aryanb1032/KASHIF-Autonomous-Mapping-Rover/hardware/README.md

# Mechanical files

Original STL files are in `stl/`, with filenames preserved. All eight meshes pass binary STL length/count checks. Print units, tolerances, assembly fit and the drive layout still require physical verification. These files are not used by the Gazebo model.

`CHASSIS.STL` and `CHASSIS (1).STL` are byte-identical copies retained from the supplied folder.
