aryanb1032/KASHIF-Autonomous-Mapping-Rover/hardware/stl/tpu wheel.stl

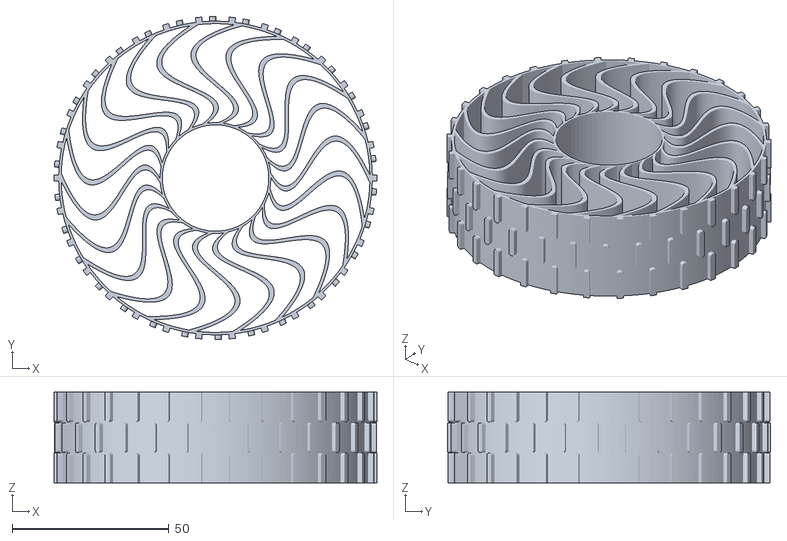
[picture p1: CAD file, 2026-11-10]
hardware/stl/tpu wheel.stl
103.0 x 103.0 x 29.0
