aryanb1032/KASHIF-Autonomous-Mapping-Rover/hardware/stl/rim.STL

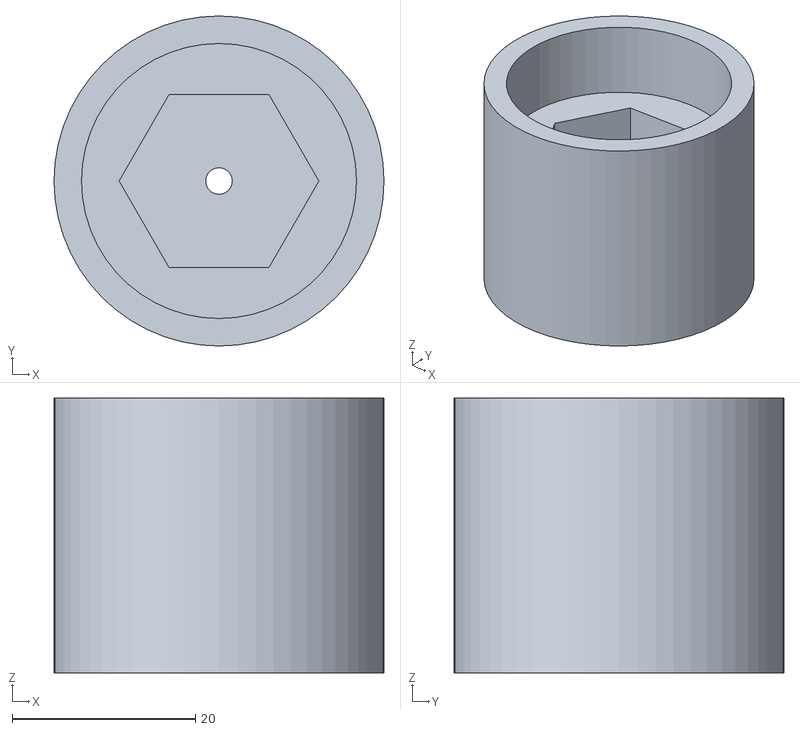
[picture p2: CAD file, 2026-11-10]
hardware/stl/rim.STL
36.0 x 36.0 x 30.0
