aryanb1032/KASHIF-Autonomous-Mapping-Rover/hardware/stl/hex 5.STL

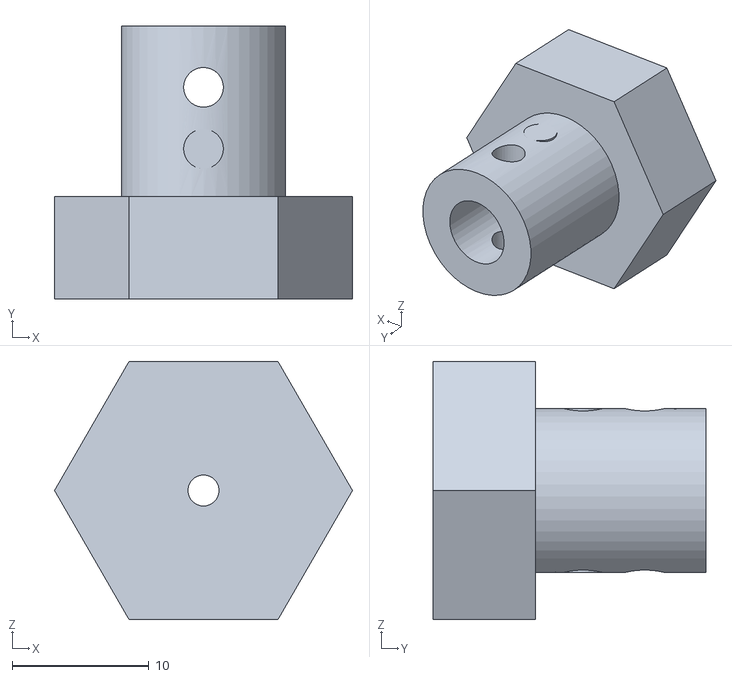
[picture p3: CAD file, 2026-11-10]
hardware/stl/hex 5.STL
21.8 x 20.0 x 18.9
