aryanb1032/KASHIF-Autonomous-Mapping-Rover/hardware/stl/lidar cover.STL

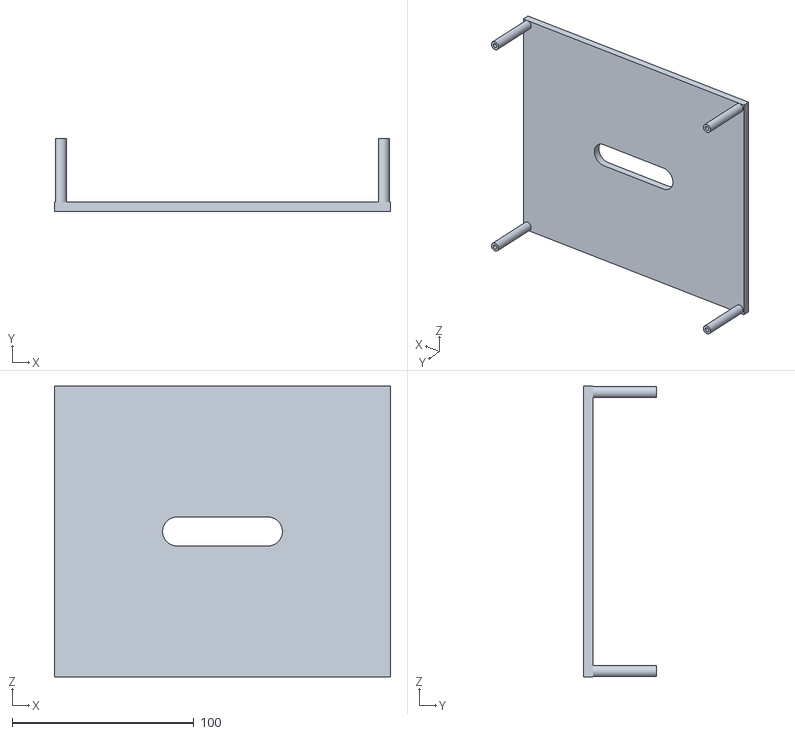
[picture p4: CAD file, 2026-11-10]
hardware/stl/lidar cover.STL
185.0 x 40.0 x 160.0
