aryanb1032/KASHIF-Autonomous-Mapping-Rover/hardware/stl/CHASSIS.STL

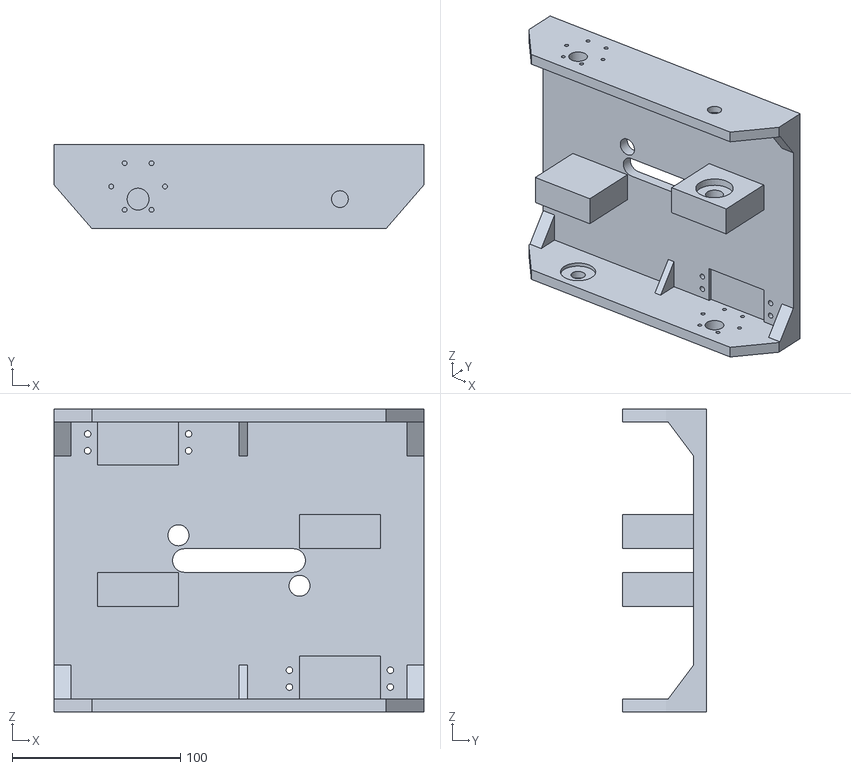
[picture p5: CAD file, 2026-11-10]
hardware/stl/CHASSIS.STL
220.0 x 50.0 x 180.0
