aryanb1032/KASHIF-Autonomous-Mapping-Rover/(list of files, cad)

Other CAD files:
hardware/stl/hex 8.STL
