aryanb1032/KASHIF-Autonomous-Mapping-Rover/(commit log)

2026-11-10 Add ESP32 motor and encoder firmware
2026-11-10 Add chassis, wheel and mounting STL files
    [CHASSIS (1).STL, CHASSIS.STL, hex 5.STL, hex 8.STL, lidar cover.STL, lock.STL, rim.STL, tpu wheel.stl]
2026-11-10 Add odometry, exploration and motion control nodes
2026-11-10 Add Gazebo world and differential-drive model
    [empty.sdf, rover.urdf.xacro]
